dw-debug/buck-converter/docs/layout-rules-original.docx

# TL494 + PNP（TIP32A）Buck PCB 布局完整笔记

电感磁芯正下方 ❌ 地铜挖掉（keepout）

适用电路：TL494 推挽输出驱动 PNP 高边功率管（TIP32A）的 Buck 降压电路，Vin 10–40V，Vout 5V/1A。

本电路特殊结构：TL494 的 7 脚（GND）接输出负端 V-，芯片浮在 V- 上，以 V- 为参考零点。

本笔记结合电路原理深度讨论与 PCB 实操布局规则，重点厘清「高频换流环路」「7脚浮地结构」「V- 地分割」「电压环反馈」「SW 与地铜间距」「反馈电阻与采样点布局」等核心概念。

# 第 0 条：先分清两类规则（全部布局的总纲）

对象 | 物理本质 | 布局规则
电流 di/dt 大 | 寄生电感产生电压尖峰 v = L·di/dt | 走线尽量短，压缩环路面积
电压 dV/dt 大 | 对地寄生电容反复充放电 → 损耗、振铃、EMI、天线辐射 | 铜皮面积能小就不铺

注意：一个节点可能两条都占。SW 节点就是"di/dt 和 dV/dt 双高"，所以对它：短是第一位的，不铺大铜皮是第二位的。优先级：短 > 粗 > 不铺。

# 一、电路结构与高频环路识别

## 1.1 电路整体结构

- 功率管：Q1 = TIP32A（PNP），发射极接 VCC，集电极 = SW 节点
- PWM 控制器：U1 = TL494，8/9 脚并联输出，经 R3 驱动 Q1 基极
- 续流二极管：D1 = MR850（超快恢复），阴极接 SW，阳极接系统地 GND
- 输出滤波：L1(1mH) + CE1(47μF) + C2(1μF)
- 电流采样：R9/R10 并联（各 0.22Ω，总 0.11Ω），串联在 V- 与系统地 GND 之间
- 指示灯：R1(150Ω) + LED1，串联在 V+ 与 V- 之间
- ⚠️ 特殊结构：TL494 的 7 脚（GND）接 V-（输出负端），不是系统地 GND。芯片所有电压以 V- 为参考。

## 1.2 高频换流环路：C3 ↔ Q1 ↔ D1

- 必须压缩环路总面积，这是抑制尖峰、EMI 的第一要务。
- C3：输入功率电容（100μF/50V 电解）+ C1(1μF) 并联，改善高频特性。
- 本电路有 C1(1μF) 并联在电解两端，高频换流主要由 C1 承担，C3 负责低频储能。
- Q1：TIP32A PNP，发射极接 VCC（固定电位，dV/dt≈0），集电极是 SW 节点。
- D1：续流二极管（MR850，超快恢复），阳极接系统地 GND。
- SW 节点电压在 VCC ↔ GND 之间高速跳变，是板上 dV/dt 最大的点。
- C1（高频陶瓷）必须紧贴 Q1 发射极–D1 阳极，高频环路按 C1–Q1–D1 布局。

## 1.3 外部电源 vs 输入电容：电流角色不同

- 外部 VCC 电源：提供平均电流，瞬时波动很小。
- 输入电容 C3/C1：Q1 导通瞬间放电送出大瞬时电流；Q1 关断时电源再补电荷。
- 结论：C3 前面平均电流不变；C3 后面（C3 到 Q1）瞬时电流高速跳变，走线必须短。

## 1.4 输出储能回路（不属于高频换流环路）

- 路径：SW → L1 → V+ → 负载 → V- → R9/R10 → GND → D1 → SW
- 电感电流连续，di/dt 远小于 SW 换流环路，这条支路要求宽松。
- 重要区分：电感电流平均值稳定，但瞬时是带纹波的三角脉动电流，不是纯直流。

## 1.5 两个"环路"概念必须分清

概念 | 包含元件 | 电流特征 | 布局要求
高频换流环路 | C1(陶瓷)–Q1–D1 | 开关边沿瞬间阶跃跳变，di/dt 极大 | 必须压缩环路面积，走线极短
功率电流回路 | SW–L1–负载–R9/R10–GND | 三角波缓慢起伏，di/dt 小但幅值大 | 环路要求宽松，但承载主功率大电流

R9/R10 不在高频换流环路内，但主功率电流全部流过 R9/R10，存在脉动压降。

# 二、SW 节点布局（最容易踩坑）

## 2.1 走线规则

- SW 走线：Q1 集电极 → D1 阴极 → L1 左端，粗而短，总长控制在 1cm 以内。
- 首选：1~2mm 粗走线；备选：几毫米局部小铜皮。
- 禁止：整片铺铜、大面积铜皮、跨层延伸、铜皮伸到电感/反馈线/芯片下方。

## 2.2 为什么 SW 不能铺铜，而 VCC 可以？

- SW 电压在 VCC ↔ GND 高速翻转，dV/dt 极大。铺铜增大对地寄生电容，带来额外开关损耗、振铃、EMI。
- VCC 走线（C3 正极 → Q1 发射极）：电流 di/dt 同样大，但电位固定，dV/dt≈0，可以铺铜，只要求短。
- 结论：电流快 → 走线要短；电压跳变快 → 不能铺铜。

## 2.3 SW 与地铜的间距

输入电压 VCC | 推荐间距 | 说明
≤ 12V | ≥ 0.3mm（12mil） | 主要防寄生电容
12~24V | ≥ 0.4~0.5mm（16~20mil） | 常用范围
24~40V | ≥ 0.5~0.8mm（20~32mil） | 本电路最高 40V，建议取 0.5mm 以上

- 本电路 VCC 最高 40V，建议间距 ≥ 0.5mm（20mil）。
- SW 走线两侧的地铜（系统地 GND）全部遵守此间距，不要紧贴。

⚠️ 重要：SW 与地铜的间距只影响 SW 对地寄生电容，与高频换流环路面积没有直接关系。

- 高频环路面积由 Q1、D1、C1 的物理位置和走线长度决定，SW 到地铜的空隙不改变环路边长。
- 间距不需要无限大，0.3~0.8mm 后收益边际递减。

## 2.4 上层走 SW，底层能不能铺 GND？

✅ 可以铺底层 GND，但 SW 走线正下方的底层地铜必须挖空。

方案 | 做法 | 效果
✅ 推荐 | 底层铺 GND，SW 正下方挖空 | 既有完整地平面做参考，又避免 SW 寄生电容
❌ 不推荐 | 底层完整 GND，SW 直接在上面 | 寄生电容大，开关尖峰、EMI 明显变差
❌ 极端 | 底层完全不铺地 | 信号地没有参考平面，回路面积大，反而更差

- 挖空范围：以 SW 走线为中心，向两侧各扩展 0.5~1mm，底层地铜全部挖掉；挖空长度 = SW 走线全长。
- 挖空只针对 SW 垂直投影区域，其他区域保留完整地平面。
- 注意：本电路底层地是系统地 GND（不是 V-），SW 正下方挖的是 GND 铜。

# 三、7 脚浮地结构与电压反馈（核心原理）

## 3.1 7 脚接 V- 的特殊结构

本电路 TL494 的 7 脚（GND）不是接系统地 GND，而是接输出负端 V-。

- 芯片所有内部电路以 V- 为 0V 参考点（浮地结构）。
- Vref（14 脚）= 5V，是相对于 V- 的 5V。
- VCC（12 脚）供电电压 = 输入 VCC − V-，对芯片来说是正电源。
- 系统地 GND 相对于 V- 的电压 = −I_load × R_sense（负电压，因为电流从 V- 经 R9/R10 流向 GND）。

## 3.2 电压反馈环结构（已确认正确）

引脚连接：

- 1 脚 IN1+（同相）：通过 R8(5.1K) 接 V+（输出正端）。输入阻抗极高，1 脚电压 ≈ V+（相对于 V-），即 ≈ Vout。
- 2 脚 IN1-（反相）：通过 R12(5.1K) 接 Vref（5V 基准），通过 R6(1M) 接 V-（芯片地）。
- R8 和 R12 没有连在一起，分别属于 1 脚和 2 脚，不构成分压网络。

2 脚基准电压计算：

- V(2脚) = 5V × R6 / (R6 + R12) = 5V × 1M / (1M + 5.1K) ≈ 4.975V ≈ 5V
- 因为 R6(1M) >> R12(5.1K)，V- 通过 R6 对 2 脚的影响被衰减约 200 倍，2 脚近似为固定 5V 基准。

负反馈闭环推演：

- Vout ↑ → 1 脚电压 ↑ → 误差放大器输出 COMP(3脚) ↑
- TL494 内部 PWM 比较器：COMP 接同相端，锯齿波接反相端 → COMP ↑ → 锯齿波大于 COMP 的时间变短 → 输出低电平时间变短
- PNP 管 Q1：8/9 脚输出低电平 = 导通 → 低电平时间变短 = Q1 导通时间缩短
- Q1 导通时间缩短 → 向电感输送能量减少 → Vout ↓（回归稳压值）✅
- 稳压条件：1 脚 ≈ 2 脚 → Vout ≈ 5V ✅

⚠️ 关键理解：TL494 的 PWM 比较器自带一次相位反转（COMP 升高反而压缩导通脉冲），叠加 PNP 低电平导通，整体环路为负反馈。

## 3.3 电流采样环（15/16 脚）

- 15 脚 IN2-（反相）：R7(5.1K) 接 Vref，R11(5.1K) 接 V-（芯片地）→ 15 脚 = 2.5V 基准（相对于 V-）。
- 16 脚 IN2+（同相）：接电流采样点。
- R9/R10 并联 = 0.11Ω，串联在 V- 与系统地 GND 之间。
- V- 相对于 GND = I_load × 0.11Ω（正电压）；GND 相对于 V- = −I_load × 0.11Ω（负电压）。

⚠️ 电流环接法注意事项：

- 如果 16 脚接系统地 GND：GND 相对于芯片地（V-）是负电压，TL494 输入引脚不能正常处理负电压，电流环可能无法工作。
- 如果 16 脚接 V-：16 脚 = 0V，15 脚 = 2.5V，IN2+ < IN2-，永远不触发保护。
- 建议：确认 16 脚实际连接。若要正常实现过流保护，需将采样电阻移到 V+ 高边，或使用差分电平转换。

## 3.4 过流保护阈值（当前参数）

- 若电流环按 15 脚=2.5V 基准、采样电阻 0.11Ω 计算：
- 保护电流 = 2.5V / 0.11Ω ≈ 22.7A
- 对 5V/1A 电路来说阈值过高，输出短路时保护可能来不及动作。
- 建议优化：将 R7 改为 47K（R11 保持 5.1K），15 脚基准降至 ≈0.48V，保护电流 ≈4.4A。

# 四、地分割：V- 分割（核心布局规则）

## 4.1 为什么分割 V-，不分割 GND？

分割地的根本原则：芯片的参考零点（7 脚接的那个网络），不能让功率大电流流过，否则地弹污染基准。

网络 | 芯片是否参考 | 流过电流 | 是否需要分割
V-（输出负端） | ✅ 是，7脚=V-，芯片参考零点 | 全部负载电流（经 R9/R10 流向 GND） | ✅ 必须分割
GND（系统地） | ❌ 没有芯片引脚接 GND | D1续流电流、C3脉冲电流、R9/R10电流 | ❌ 不需要，全是功率地

- 普通 Buck：7 脚接 GND → 分割 GND。
- 本电路：7 脚接 V- → 分割 V-。GND 全是功率元件，整片铺铜不用分。

## 4.2 V- 具体分割方式

V- 物理上分成两块铜：

功率 V- 铜（承载大电流）：

- 包含：输出 V- 端子、CE1/C2 负极、LED 负极、R9/R10 上端（V- 侧）
- 承载全部负载电流，大面积铺铜
- 止步于 R9/R10 上端，不延伸到 TL494 芯片区域

信号 V- 铜（芯片参考地）：

- 包含：TL494 的 7 脚、R6 下端、R11 下端、补偿网络地、其他以 V- 为参考的小信号元件
- 只有 μA 级小信号电流，电位稳定，给芯片提供干净的 0V 参考

单点连接：

- 功率 V- 和信号 V- 只在一处相连，连接点选在 **R9/R10 上端（V- 侧）**
- 这里是功率 V- 的终点，功率电流全部流入 R9/R10，不再往前流，电位最平稳
- 用一根短线或 0Ω 电阻连接
- ❌ 禁止在输出电容负极或负载端子处连接（那里功率电流大、地弹大）
- ❌ 禁止多点连接（形成地环路）

## 4.3 GND（系统地）处理

- 不需要分割，整片铺功率铜。
- 包含：D1 阳极、C3 负极、C1 负极、R9/R10 下端、输入电源负极。
- 大面积铺铜，降低阻抗，承载功率大电流。
- 因为没有芯片小信号参考 GND，不用担心地弹污染基准。

## 4.4 分割结构示意

输出 V- 端子 ──[功率 V- 铜，大电流]──┬── CE1/C2 负极

├── LED 负极

└── R9/R10 上端（V- 侧）

│

[单点连接] ← 唯一连接处

│

┌── 7 脚（TL494 地）

├── R6 下端、R11 下端

└── 其他小信号元件地

[信号 V- 铜，μA级小电流]

# 五、反馈电阻与采样点布局

## 5.1 反馈电阻必须靠近 TL494 芯片

- R8、R12、R6、R4、C4、R7、R11 全部连接 TL494 高阻抗引脚（1/2/3/14/15 脚），输入阻抗 MΩ 级，极易耦合噪声。

走线类型 | 电流大小 | 是否可以长 | 布局要求
采样线（V+/V- → 反馈电阻） | nA~μA级 | ✅ 可以长 | 0.2~0.3mm 细线，从输出端子引出
反馈电阻 → 芯片引脚 | 高阻抗节点 | ❌ 必须短 | 电阻紧贴芯片，引脚走线尽量短
功率走线（L1→C4→V+端子） | A级大电流 | 尽量短粗 | 宽铜皮，承载大电流

核心原则：采样点靠近输出端子，反馈电阻靠近芯片，中间用细采样线连接。

## 5.2 反馈采样点位置

- V+ 采样：从输出 V+ 端子（或 CE1 正极）引出细采样线 → R8 → 1 脚。
- V- 参考：2 脚通过 R6 接信号 V-（芯片地），不需要额外从功率 V- 引线。
- ❌ 不要从 L1→C4 之间的功率走线取 V+ 采样，那段走线上流过全部电感电流，有 IR 压降和 L·di/dt 尖峰，且靠近 SW/电感，磁场干扰强。
- L1 和 CE1 尽量靠近，缩短 L1→CE1 功率走线，减小 IR 压降和寄生电感。

## 5.3 反馈走线注意事项

- 反馈采样线用 0.2~0.3mm 细线，远离 SW 走线和 L1 电感，不要平行走。
- 反馈线不要从高频换流环路（C1-Q1-D1）上方或下方穿过。
- R8、R12、R6 等反馈电阻放在 TL494 周边的小信号区，不放功率区。
- 补偿电容 C4(104) 紧贴 2 脚、3 脚，引线尽量短。

# 六、分区布局：功率区 / 小信号控制区

## 6.1 功率区

- 包含：C3、C1、Q1、D1、L1、CE1、C2、R9/R10、R1/LED1
- C1（高频陶瓷）、C3、Q1、D1 四者紧靠，构成紧凑的换流三角。
- 系统地 GND 大面积铺铜（纯功率地，不分割）。
- 功率 V- 铜承载负载大电流，止步于 R9/R10 上端。
- L1、CE1/C2 属低频回路，V+ 可铺铜。
- L1 和 CE1 尽量靠近。

## 6.2 小信号区

- 包含：TL494 及反馈电阻（R8、R12、R6、R4、R7、R11）、补偿电容（C4）、定时元件（R5、C5）。
- TL494 不得放在高频环路包围/投影范围内，远离电感磁场。
- TL494 12 脚 VCC 紧贴引脚加 0.1μF 去耦电容（原理图无，PCB 必须补），去耦电容另一端接信号 V-（7脚）。
- 14 脚 Vref 旁同样建议加 0.1μF 去耦（到信号 V-）。
- 定时元件 R5(47K)、C5(102) 紧贴 5、6 脚。
- 反馈电阻紧贴 TL494 的 1/2/3 脚，高阻抗节点走线尽量短。
- 信号 V- 铜只覆盖小信号区，通过单点连到功率 V-（R9/R10 上端）。

# 七、基极驱动走线：TL494（8/9 脚）→ R2/R3 → Q1 基极

- 走线尽量短，0.2~0.3mm 细线即可，不用加宽。
- R2(47Ω)：Q1 基极到发射极（VCC）的关断泄放电阻，帮助 Q1 快速关断。
- R3(150Ω)：8/9 脚到 Q1 基极的驱动限流电阻。
- R2、R3 紧贴 Q1 基极，让 R2/R3/Q1 基极构成紧凑的小驱动环路。
- 长线寄生电感 → 开关瞬间振铃电压尖峰；长线像天线 → 拾取噪声误触发；长线电阻 → 驱动不足发热。

# 八、走线宽度规范（1oz 外层铜）

网络 | 处理方式
VCC（C3 正极 → Q1 发射极） | 可铺铜 / 1.5~2mm
SW 节点 | 1~2mm 粗短线，禁止大面积铺铜
SW 与 GND 间距 | ≥ 0.5mm，底层 SW 正下方挖空
L1 → CE1 → V+ 功率走线 | 宽铜皮 / 1.5~2mm，尽量短
V+ 输出 | 允许大面积铺铜
功率 V- 铜 | 功率区大面积铺铜，止步于 R9/R10 上端
信号 V- 铜 | 小信号区铺铜，仅 μA 级电流
GND（系统地） | 整片铺功率铜，不分割
V+ 采样线 | 0.2~0.3mm 细线，从输出端子引出
基极驱动、反馈电阻、补偿、定时 | 0.2~0.3mm 细线，电阻紧贴芯片

# 九、避坑清单

- ❌ SW 走线大面积铺铜 / 铺成天线
- ❌ SW 与 GND 间距过小（< 0.3mm），寄生电容大
- ❌ 上层走 SW，底层 GND 不挖空，SW 正下方寄生电容大
- ❌ 误以为 SW 与地铜间距变大会增大高频环路面积（二者无直接关系）
- ❌ C1（高频陶瓷）放远，高频环路面积大
- ❌ C3/C1 放到 TL494 旁边
- ❌ TL494 放在高频环路包围区域内
- ❌ 分割 GND 而不分割 V-（本电路 7 脚=V-，应该分割 V-，GND 是纯功率地不用分）
- ❌ 功率 V- 铜延伸到 TL494 小信号区域
- ❌ 功率 V- 和信号 V- 多点连接，或在输出电容负极处连接（应在 R9/R10 上端单点连接）
- ❌ 功率大电流流过信号 V- 铜（TL494 下方）
- ❌ 反馈电阻（R8/R12/R6）放在功率区，远离 TL494，高阻抗节点走线长
- ❌ V+ 采样点取在 L1→CE1 之间的功率走线上（应取输出端子或 CE1 正极）
- ❌ 反馈采样线靠近 SW 走线、电感，或从高频环路上方穿过
- ❌ L1 和 CE1 距离过远，L1→CE1 走线过长
- ❌ 拉长基极驱动走线，或 R2/R3 远离 Q1 基极
- ❌ 省略 TL494 12 脚 VCC 去耦电容（去耦到信号 V-，不是 GND）
- ❌ 续流二极管 D1 用普通慢管或放远，环路面积变大
- ❌ 16 脚接系统地 GND（相对于 V- 是负电压，TL494 无法处理，需确认接法）
- ❌ 过流保护阈值过高（当前约 22.7A，建议降低基准到 0.5V 左右）
- ❌ LED 限流电阻 150Ω 偏小（电流约 20mA，建议 330~470Ω）

# 十、核心口诀

电流突变，走线缩短；电压猛跳，少铺大铜；
先缩环路，再谈铺铜；高频小容，贴紧功率；
七脚接V负，芯片浮在地；
分地看七脚，接谁就分谁；
V负分两块，单点在采样；
GND全功率，整片铺铜皮；
电阻靠近芯片，采样靠近端子；
SW离地半毫米，底层正下要挖空。

一句话记忆：7 脚接谁，谁就是芯片参考地，谁就需要分割功率/信号。本电路 7 脚接 V-，所以分割 V-，GND 不用分。

一句话记忆：SW 与地铜间距只影响寄生电容，不直接影响高频环路面积；上层走 SW，底层铺地但正下方挖空。

一句话记忆：反馈电阻靠近芯片，采样点靠近输出端子，中间细采样线连接。

一句话记忆：TL494 的 PWM 比较器自带相位反转，COMP 升高反而压缩导通脉冲，叠加 PNP 低电平导通形成负反馈。
