dw-debug/buck-converter/docs/BOM.csv

Name | Description | Designator | Footprint | LibRef | Quantity | 参数 | BOM名称
1uF | 贴片电容/MLCC电容 | C1, C2, C3, C6 | C0805_L | C | 4 |  | 无极性贴片电容
104 | 瓷片电容 | C4 | CC 2.2*5 | CC | 1 |  | 直插瓷片电容
102 | 瓷片电容 | C5 | CC 2.2*5 | CC | 1 |  | 直插瓷片电容
47uF/25V | 直插电解电容 | CE1 | CE-2.0*5*11 | CE | 1 |  | 直插电解电容
100uF/50V | 直插电解电容 | CE2 | CE-3.5*8*11.5 | CE | 1 |  | 直插电解电容
MR850 | 恢复二极管整流器 | D1 | DO-201AD | FR307 | 1 |  | 恢复二极管整流器
TL494 | 电源管理IC | i1 | DIP16-300 | TL494 | 1 |  | 电源管理IC
HDR-1X2 | 2P接插件 | JP1, JP2, JP3, JP4 | KF2EDGK5.08-LI-2P | Header 2 | 4 |  | 2P接插件 | 是U型针
1mH | 功率磁环电感 | L1 | LMR135 | L-MR | 1 |  | 功率磁环电感
红色 | 贴片LED | LED1 | LED0603_R | LED | 1 |  | 贴片LED
TIP32A | PNP型中功率三极管 | Q1 | TO220A | TIP42C | 1 | 100V 6A 65W | 互补功率-PNP型
150 | 直插色环电阻 | R1 | RS 1/2W | R-DIP | 1 |  | 色环电阻
47 | 直插色环电阻 | R2 | RS 1/4W | R-DIP | 1 |  | 色环电阻
150 | 直插色环电阻 | R3, R11 | RS 1/4W | R-DIP | 2 |  | 色环电阻 | R3可以大一点限流
47K | 直插色环电阻 | R4, R5 | RS 1/4W | R-DIP | 2 |  | 色环电阻
1M | 直插色环电阻 | R6 | RS 1/4W | R-DIP | 1 |  | 色环电阻
5.1K | 直插色环电阻 | R7, R8, R12 | RS 1/4W | R-DIP | 3 |  | 色环电阻
0.22 | 直插色环电阻 | R9, R10 | RS 1/4W | R-DIP | 2 |  | 色环电阻
15.5*10.5*21 | 产品尺寸:15.5*10.5*21MM;材 质:6063-T5; | U1 | PCBComponent_1 | 15.5*10.5*21 | 1 |  |  | 别忘记了，买云母绝缘片
