dw-debug/buck-converter/(list of files, cad)

Other CAD files:
hardware/PCB1.DWG
Sheet1.dwg
hardware/Sheet1.dwg
