dw-debug/buck-converter/docs/layout-guidelines.md

# TL494 + PNP Buck PCB 布局规则

> 适用对象：TL494 推挽输出直接驱动 PNP 高边管（TIP32A）的 Buck 降压电路，V<sub>in</sub> 10–40 V，V<sub>out</sub> 5 V / 1 A。
> 本文由布局笔记整理（原稿见 [layout-rules-original.docx](layout-rules-original.docx)），可直接当作改板 checklist 使用。
> 本电路的关键特殊结构：**TL494 的 7 脚（GND）接输出负端 V-**，芯片以 V- 为 0 V 参考，即"浮地"结构——后面所有地分割规则都由这一条推出。

---

## 0. 总纲：先分清两类规则

| 物理本质 | 后果 | 布局规则 |
| --- | --- | --- |
| 电流 di/dt 大 | 寄生电感产生电压尖峰 v = L·di/dt | 走线尽量短，压缩环路面积 |
| 电压 dV/dt 大 | 对地寄生电容反复充放电 → 损耗、振铃、EMI、天线辐射 | 铜皮面积能小就小 |

一个节点可能两条都占（SW 节点就是 di/dt 与 dV/dt 双高）。**优先级：短 > 粗 > 不铺。**

## 1. 电路结构与两个"环路"

| 概念 | 包含元件 | 电流特征 | 布局要求 |
| --- | --- | --- | --- |
| **高频换流环路** | 输入高频电容（C1 1 µF）– Q1 – D1 | 开关边沿瞬间阶跃，di/dt 极大 | 必须压缩环路面积，走线极短 |
| **功率回路** | SW–L1–负载–R9/R10–GND | 三角波缓慢起伏，di/dt 小但幅值大 | 要求宽松，但要走足够宽 |

- 输入侧：电解 CE2（100 µF/50 V，笔记原文记作 C3）+ C1（1 µF）并联。**高频换流由 C1 承担，CE2 只负责低频储能**，所以 C1 必须紧贴 Q1 发射极–D1 阳极。
- 输入电解之前的平均电流不变；**CE2 到 Q1 之间瞬时电流高速跳变**，该段走线才要短。
- R9/R10 不在高频换流环路内，但主功率电流全部流过它（存在脉动压降），故功率回路与换流环路要分开考虑。

## 2. SW 节点（最容易踩坑）

- 走线：Q1 集电极 → D1 阴极 → L1 左端，**粗而短，全长 ≤ 1 cm**；首选 1–2 mm 粗线，备选几毫米局部小铜皮。
- **禁止**：整片铺铜、大面积铜皮、跨层延伸、铜皮伸到电感 / 反馈线 / 芯片下方。
- 为什么 SW 不能铺铜而 VCC 可以：SW 电位在 VCC ↔ GND 之间高速翻转（dV/dt 极大），铺铜等于加大对地寄生电容 → 开关损耗、振铃、EMI；VCC 走线 di/dt 同样大但**电位固定、dV/dt≈0**，所以可以铺铜，只要求短。
- SW 与地铜间距（本电路最高 40 V）：

  | VCC | 推荐间距 |
  | --- | --- |
  | ≤ 12 V | ≥ 0.3 mm (12 mil) |
  | 12–24 V | ≥ 0.4–0.5 mm (16–20 mil) |
  | 24–40 V | ≥ 0.5–0.8 mm (20–32 mil) |

  0.3–0.8 mm 之后收益边际递减，不必无限加大。
- ⚠️ SW 与地铜的间距**只影响 SW 对地寄生电容，与高频换流环路面积没有直接关系**；环路面积由 Q1、D1、C1 的物理位置和走线长度决定。
- 底层可以铺 GND，但 **SW 走线正下方的底层地铜必须挖空**：以 SW 走线为中心向两侧各扩 0.5–1 mm，挖空长度 = SW 走线全长；其他区域保留完整地平面。挖的是**系统地 GND 铜**（不是 V-）。

## 3. 地分割：分割 V-，不分割 GND

分割地的根本原则：**芯片的参考零点（7 脚所在的网络）不能让功率大电流流过**，否则地弹污染基准。本电路 7 脚接 V-，所以分割的是 V-。

| 网络 | 芯片是否参考 | 流过电流 | 是否分割 |
| --- | --- | --- | --- |
| V-（输出负端） | ✅ 7 脚 = V-，芯片参考零点 | 全部负载电流（经 R9/R10 流向 GND） | ✅ 必须分割 |
| GND（系统地） | ❌ 无芯片引脚接 GND | 续流电流、输入脉冲电流、R9/R10 电流 | ❌ 不需要，整片功率铜 |

**功率 V- 铜**（大电流）：输出 V- 端子、CE1/C2 负极、LED 负极、R9/R10 上端（V- 侧）。大面积铺铜，**止步于 R9/R10 上端**，不延伸到 TL494 区域。

**信号 V- 铜**（芯片参考地，仅 µA 级）：TL494 的 7 脚、R6/R11 下端、补偿网络地、其他以 V- 为参考的小信号元件。只覆盖小信号区，电位稳定。

**单点连接**：两块 V- 只在一处相连，连接点选在 **R9/R10 上端（V- 侧）**——这里是功率 V- 的终点，功率电流全部流入采样电阻、不再前流，电位最平稳；用一段短线或 0 Ω 电阻连接。

```
输出 V- 端子 ──[功率 V- 铜，大电流]──┬── CE1/C2 负极
                                     ├── LED 负极
                                     └── R9/R10 上端 (V- 侧)
                                            │
                                      [单点连接]  ← 唯一连接处
                                            │
                                     ┌── 7 脚 (TL494 地)
                                     ├── R6 / R11 下端
                                     └── 其他小信号元件地
                                     [信号 V- 铜，µA 级]
```

❌ 禁止在输出电容负极或负载端子处单点连接（那里功率电流大、地弹大）；❌ 禁止多点连接（形成地环路）。

## 4. 电压反馈与采样

- **IN1+（1 脚）**经 R8（5.1 K）接 V+，输入阻抗 MΩ 级，1 脚电压 ≈ V<sub>out</sub>。
- **IN1-（2 脚）**与 R12（5.1 K）、R6（1 M）构成基准：R6 ≫ R12，使 V- 对 2 脚的影响被衰减约 200 倍，2 脚 ≈ 4.975 V ≈ 固定 5 V 基准。
- **COMP（3 脚）**与 IN1- 之间接 R4（47 K）∥ C4（100 nF）作补偿。
- 负反馈推演：V<sub>out</sub>↑ → 1 脚↑ → COMP↑ → TL494 内部 PWM 比较器（COMP 接同相端、锯齿波接反相端）输出高电平时间变长 → 8/9 脚高电平变长 → PNP 低电平导通，**导通时间变短** → 送进电感的能量减少 → V<sub>out</sub>↓ ✅
  ⚠️ 关键理解：TL494 的 PWM 比较器自带一次相位反转，再叠加 PNP 的低电平导通，整体仍是负反馈。
- **布局三条**：采样点靠近输出端子、反馈电阻靠近芯片、中间用 0.2–0.3 mm 细采样线连接。
  - V+ 采样从输出 V+ 端子（或 CE1 正极）引出 → R8 → 1 脚。
  - ❌ 不要从 L1→CE1 之间的功率走线取 V+ 采样（流过全部电感电流，有 IR 压降与 L·di/dt 尖峰，且靠近 SW/电感）。
  - 反馈线远离 SW 走线与 L1，不平行走，不从高频环路上/下方穿过；C4 紧贴 2/3 脚。

## 5. 电流采样环（15/16 脚）

- 采样电阻 R9 ∥ R10 = **0.11 Ω**，串在 V- 与系统地 GND 之间。
- V- 相对 GND = +I<sub>load</sub> × 0.11 Ω；GND 相对 V- = −I<sub>load</sub> × 0.11 Ω（负压）。
- 15 脚（IN2-）由 R7/R11 分压建立基准，16 脚（IN2+）接采样点。
- ⚠️ **待核实**：原笔记按 R11 = 5.1 K 推算 15 脚 = 2.5 V、保护阈值 ≈ 22.7 A（对 1 A 电路明显过高）。但 BOM 中 **R11 = 150 Ω（与 R3 同值）**，R7 = 5.1 K，分压比 1:34 → 15 脚 ≈ 0.143 V、阈值 ≈ 1.3 A，与 1 A 满载 + 实测限流行为吻合。两种推算只差一个 R11 取值，**以 `hardware/PCB1.PcbDoc` 网络表为准**。
- 若确实需要降阈值：R7 改 47 K（R11 保持 5.1 K）可把基准压到 ≈0.48 V。更彻底的做法是把采样电阻移到 V+ 高边，或加差分电平转换——因为 16 脚若接系统地，相对芯片地是负压，TL494 输入无法正常处理。

## 6. 分区：功率区 / 小信号控制区

**功率区**：CE2、C1、Q1、D1、L1、CE1、C2、R9/R10、R1/LED1。四个换流元件（C1、CE2、Q1、D1）紧靠成紧凑三角；GND 整片铺铜不分割；L1 与 CE1 尽量靠近（缩短 IR 压降与寄生电感）；V+ 允许大面积铺铜。

**小信号区**：TL494 + R8/R12/R6/R4/R7/R11 + C4 + 定时元件 R5/C5。
- TL494 不得落进高频环路的包围/投影范围，远离电感磁场。
- **12 脚 VCC 紧贴引脚加 0.1 µF 去耦电容（原理图没有，PCB 必须补），另一端接信号 V-（7 脚），不是 GND**；14 脚 Vref 同样建议 0.1 µF 到信号 V-。
- R5（47 K）、C5（1 nF）紧贴 5/6 脚；反馈电阻紧贴 1/2/3 脚。

## 7. 基极驱动走线（8/9 脚 → R2/R3 → Q1 基极）

- 0.2–0.3 mm 细线即可，不必加宽，但**必须短**。
- R2（47 Ω）：Q1 基极–发射极之间的关断泄放电阻；R3（150 Ω）：驱动限流电阻。**R2/R3 紧贴 Q1 基极**，与基极构成紧凑的小驱动环路。
- 长线后果：寄生电感 → 开关振铃尖峰；像天线 → 拾取噪声误触发；走线电阻 → 驱动不足、发热。

## 8. 走线宽度与处理（1 oz 外层铜）

| 网络 | 处理方式 |
| --- | --- |
| VCC（CE2 正极 → Q1 发射极） | 可铺铜 / 1.5–2 mm |
| SW 节点 | 1–2 mm 粗短线，禁止大面积铺铜，全长 ≤ 1 cm |
| SW 与 GND 间距 | ≥ 0.5 mm，底层 SW 正下方挖空 |
| L1 → CE1 → V+ 功率走线 | 宽铜皮 1.5–2 mm，尽量短 |
| V+ 输出 | 允许大面积铺铜 |
| 功率 V- 铜 | 功率区大面积铺铜，止步于 R9/R10 上端 |
| 信号 V- 铜 | 小信号区铺铜，仅 µA 级电流 |
| GND（系统地） | 整片功率铜，不分割 |
| V+ 采样线 | 0.2–0.3 mm 细线，从输出端子引出 |
| 基极驱动 / 反馈电阻 / 补偿 / 定时 | 0.2–0.3 mm 细线，电阻紧贴芯片 |

## 9. 避坑清单

- ❌ SW 大面积铺铜 / 铺成天线；SW 与 GND 间距 < 0.3 mm；底层 GND 在 SW 正下方不挖空。
- ❌ 误以为"SW 与地铜间距变大 = 环路面积变大"（二者无直接关系）。
- ❌ C1（高频陶瓷）放远、CE2/C1 放到 TL494 旁边、TL494 落进高频环路内。
- ❌ 分割 GND 而不分割 V-；功率 V- 铜延伸到 TL494 区域；V- 多点连接或在输出电容负极处单点连接。
- ❌ 反馈电阻放功率区、远离 TL494；V+ 采样取在 L1→CE1 功率走线上；采样线靠近 SW/电感或跨过环路。
- ❌ L1 与 CE1 距离过远；基极驱动走线拉长、R2/R3 远离 Q1 基极。
- ❌ 省略 TL494 12 脚 0.1 µF 去耦（且要接到信号 V-）。
- ❌ D1 用普通慢管或放远，环路面积变大。
- ❌ LED 限流电阻 150 Ω 偏小（约 20 mA），建议 330–470 Ω。

## 10. 口诀

> 电流突变，走线缩短；电压猛跳，少铺大铜；
> 先缩环路，再谈铺铜；高频小容，贴紧功率；
> 七脚接 V 负，芯片浮在地；
> 分地看七脚，接谁就分谁；
> V 负分两块，单点在采样；
> GND 全功率，整片铺铜皮；
> 电阻靠近芯片，采样靠近端子；
> SW 离地半毫米，底层正下要挖空。

一句话记忆：

1. **7 脚接谁，谁就是芯片参考地，谁就需要分割功率/信号**——本电路 7 脚接 V-，所以分割 V-，GND 不用分。
2. SW 与地铜间距只影响寄生电容，不直接影响高频环路面积；上层走 SW，底层铺地但正下方挖空。
3. 反馈电阻靠近芯片，采样点靠近输出端子，中间细采样线连接。
4. TL494 的 PWM 比较器自带相位反转，COMP 升高反而压缩导通脉冲，叠加 PNP 低电平导通形成负反馈。

## 11. 改板自查清单

- [ ] 换流三角：C1、Q1、D1 是否紧凑，C1 是否紧贴 Q1 发射极 / D1 阳极
- [ ] SW 走线是否 ≤ 1 cm 且未铺铜；与地铜是否 ≥ 0.5 mm；底层正下方是否挖空
- [ ] V- 是否分成功率/信号两块，单点是否落在 R9/R10 上端
- [ ] 是否误分割了 GND
- [ ] TL494 是否避开电感与高频环路
- [ ] 12/14 脚 0.1 µF 去耦是否到位（接信号 V-）
- [ ] 反馈电阻是否贴芯片、采样线是否从输出端子引出并远离 SW/电感
- [ ] R7/R11 分压比与目标限流是否一致；15/16 脚接法是否经过网络表确认
- [ ] R2/R3 是否贴 Q1 基极；D1 是否为快恢复/肖特基
- [ ] LED 限流电阻是否改为 330–470 Ω
