dw-debug/buck-converter/hardware/Composite Drawing.pdf

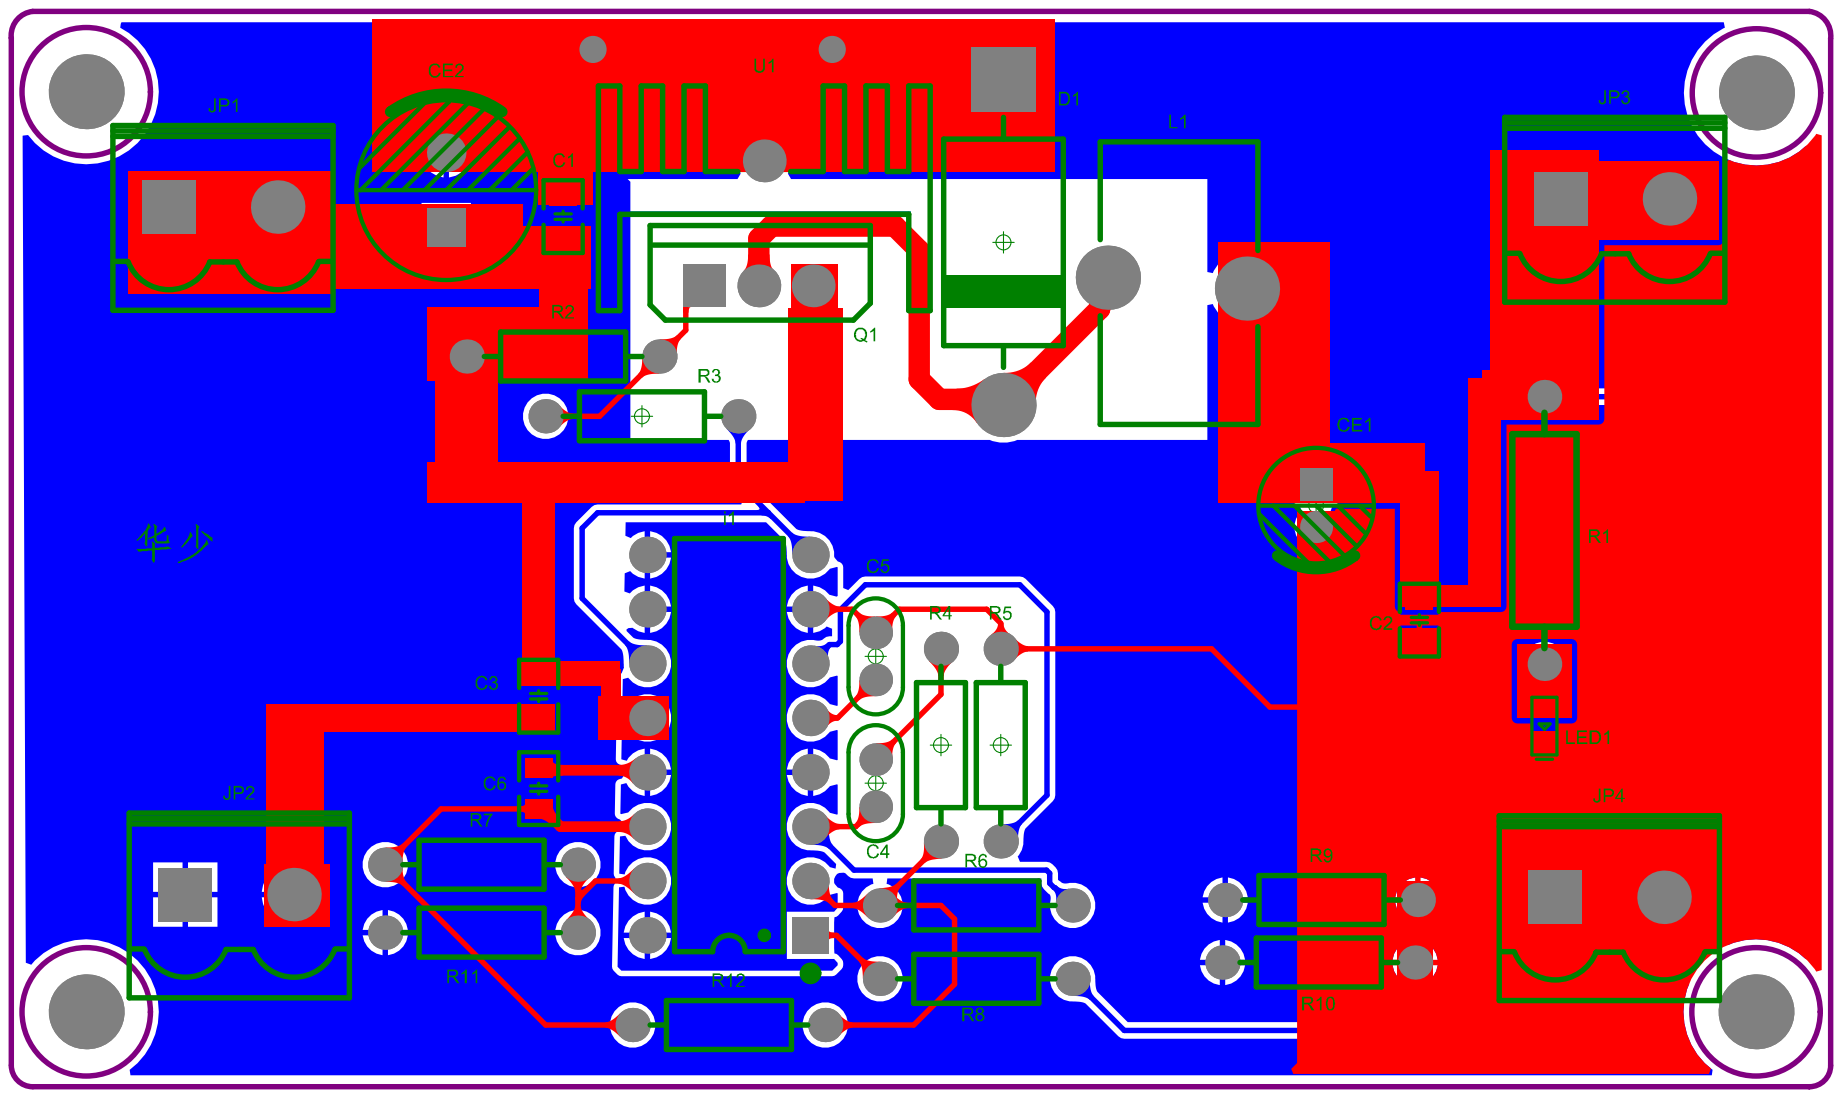
[picture p5: page 1]
