dw-debug/buck-converter/hardware/Sheet1.pdf

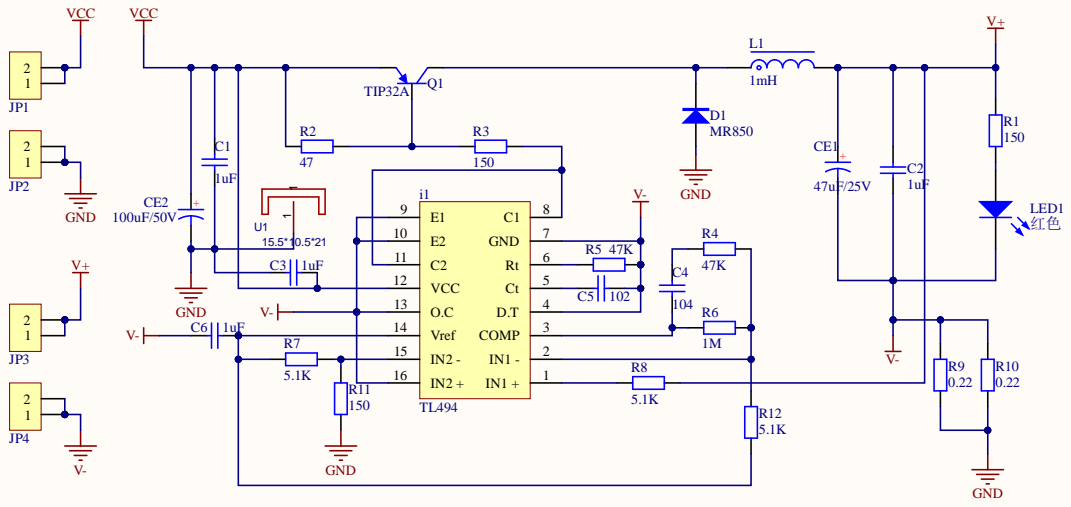
[picture p6: page 1]

1 2 | 1TL C2 Rt VCC Ct O . C D . T Vref COMP IN 2 -IN 1 -IN 2 + IN 1 +

1 0 | | 7
1 1 | | 6 | R5 4 7 K

1 3 | | 4
1 4 | | 3
1 5 | | 2
1 6

项目名 称 | b uck.Prj P cb

原理名 称 | Sheet 1.Sch D o c
项目时 间 | 2 0 2 6 / 1 0/ 1 8 1 7 : 5 3 : 1 0

设计者 | 华少
