dw-debug/buck-converter/fabrication/assembly/PCB1.pdf

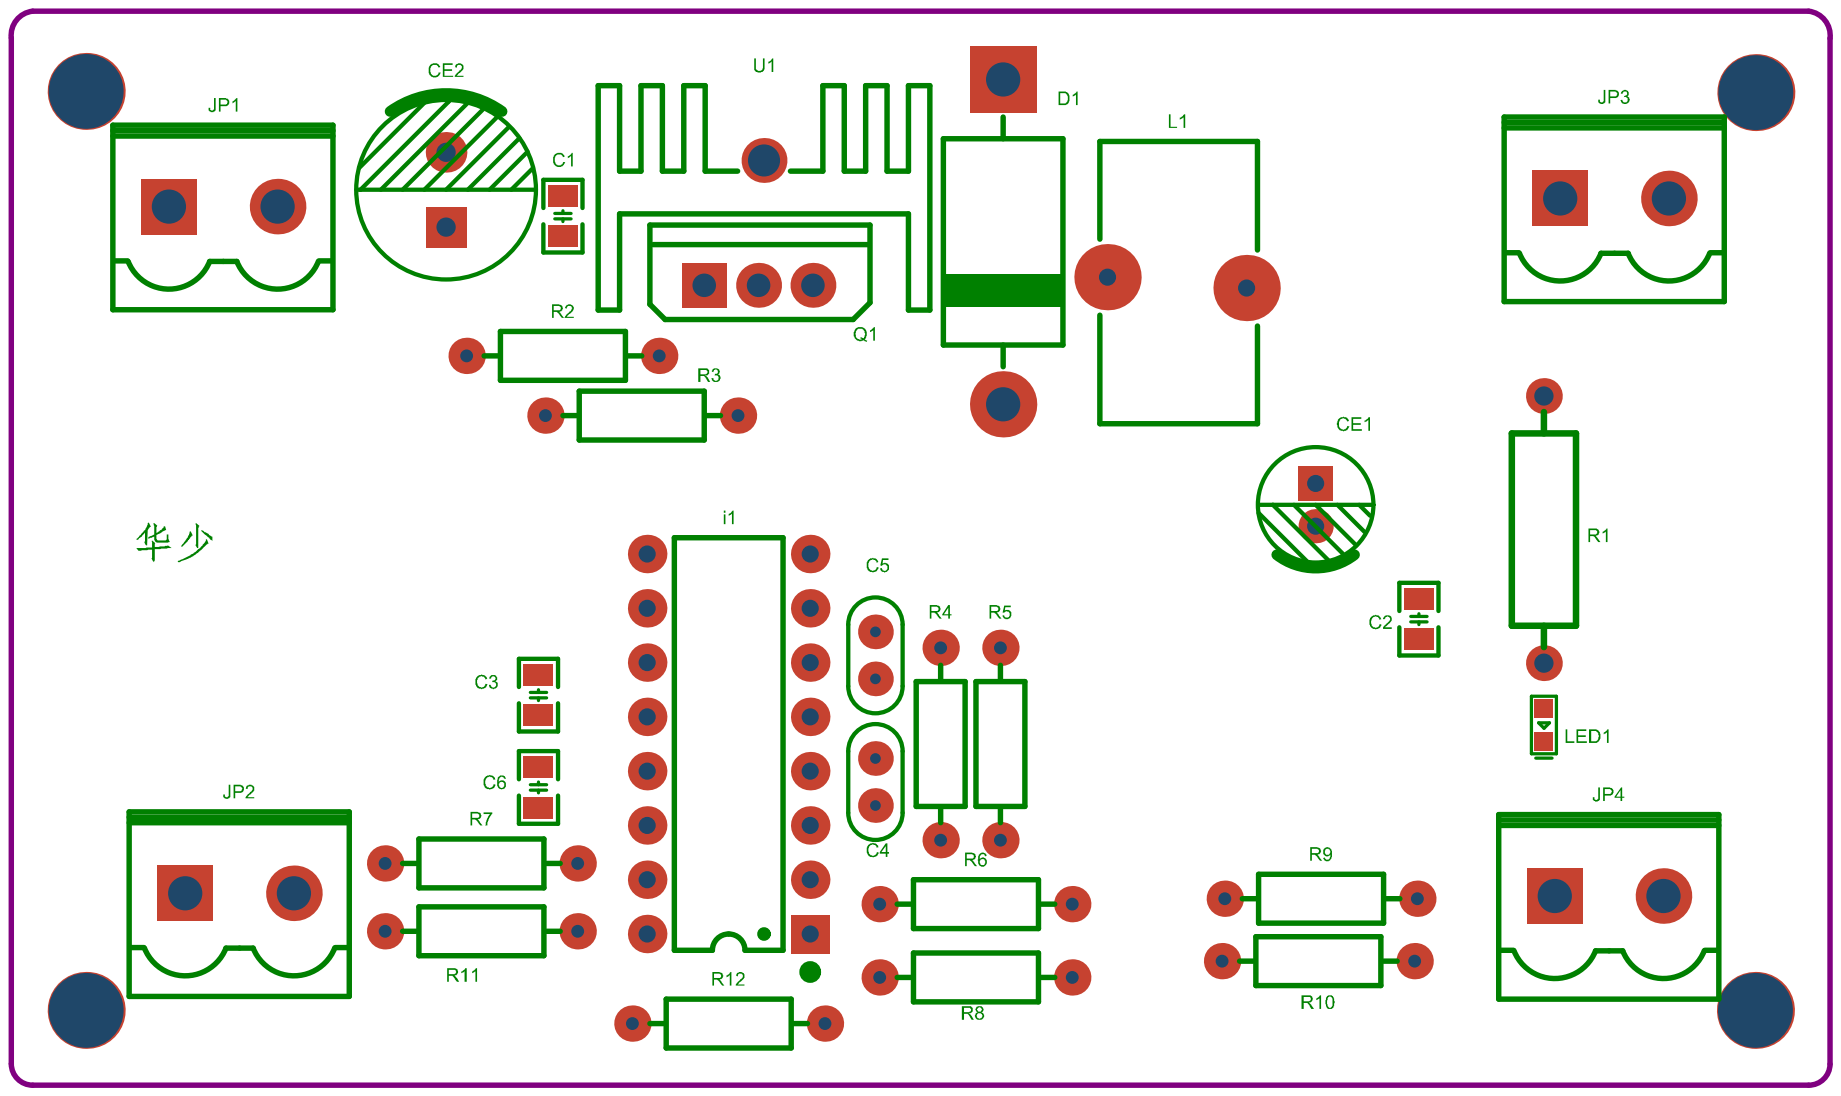
[picture p7: page 1]

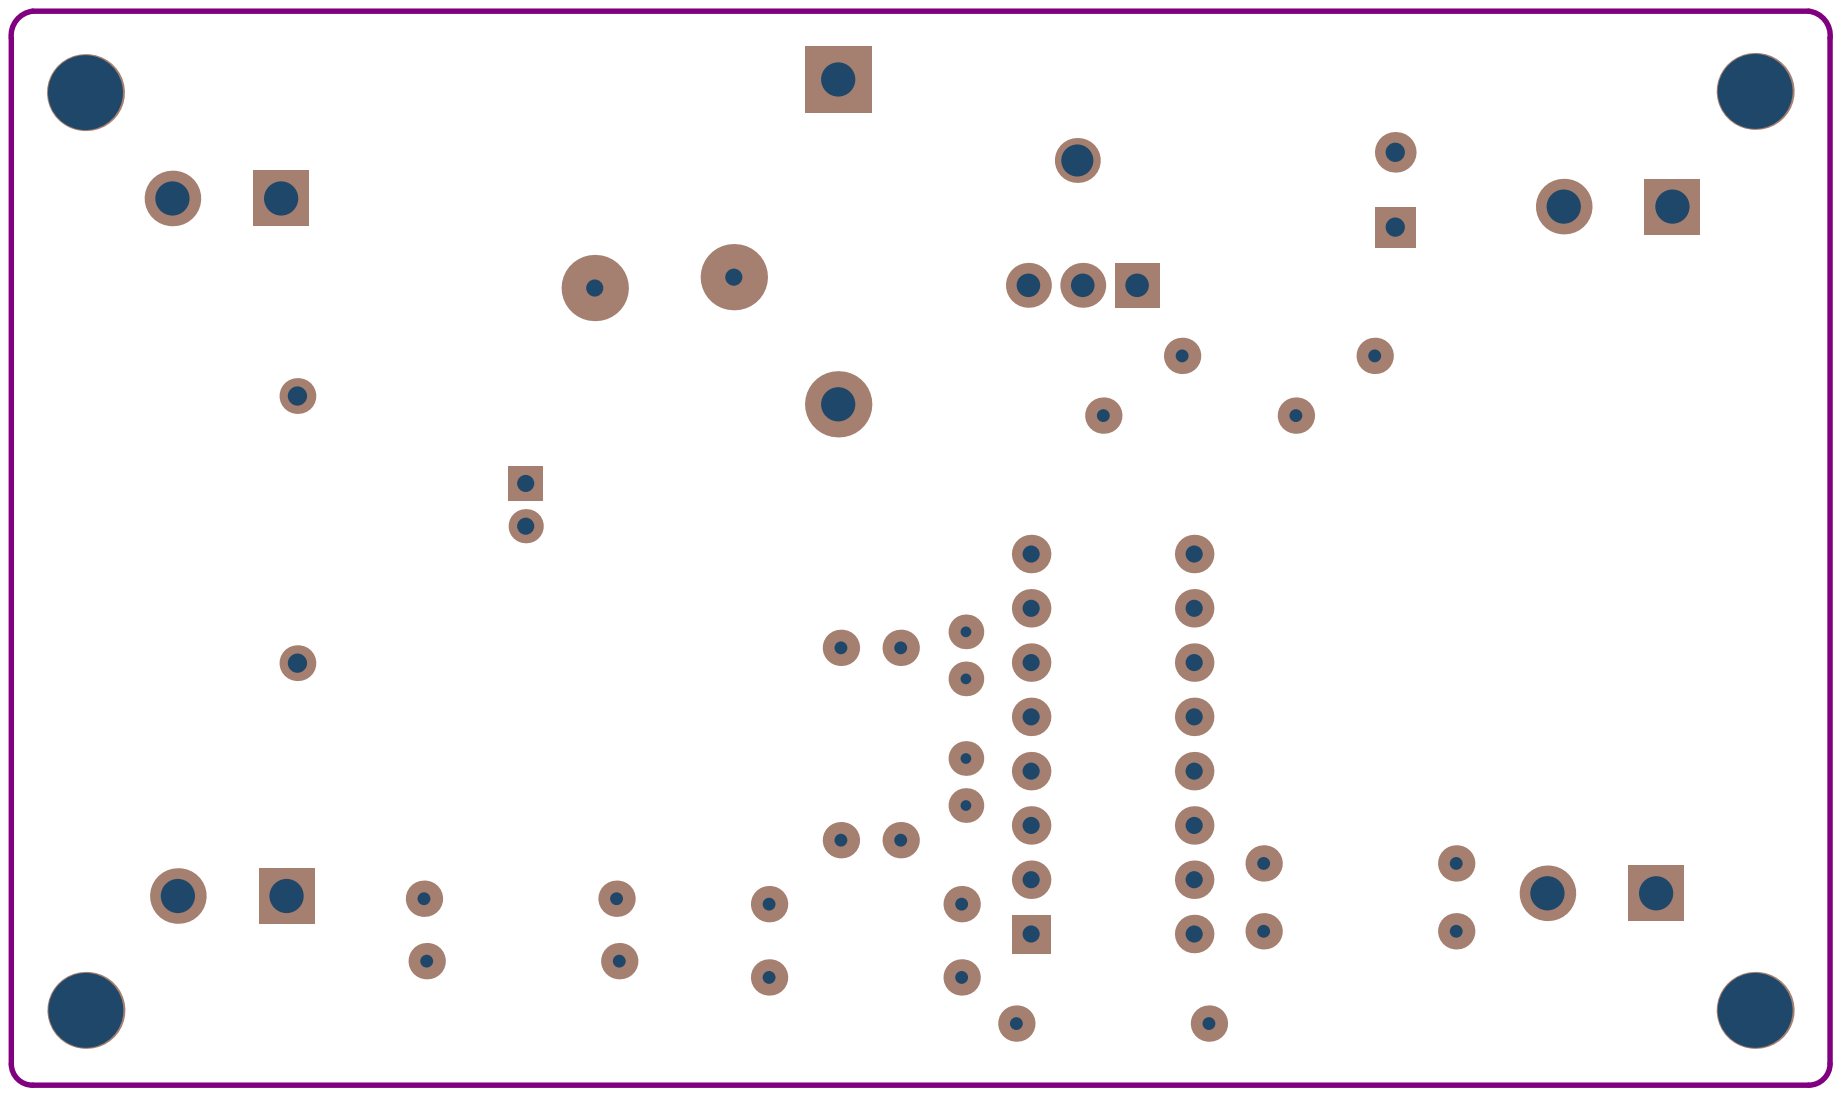
[picture p8: page 2]
