dw-debug/buck-converter/fabrication/stencil/PCB1.pdf

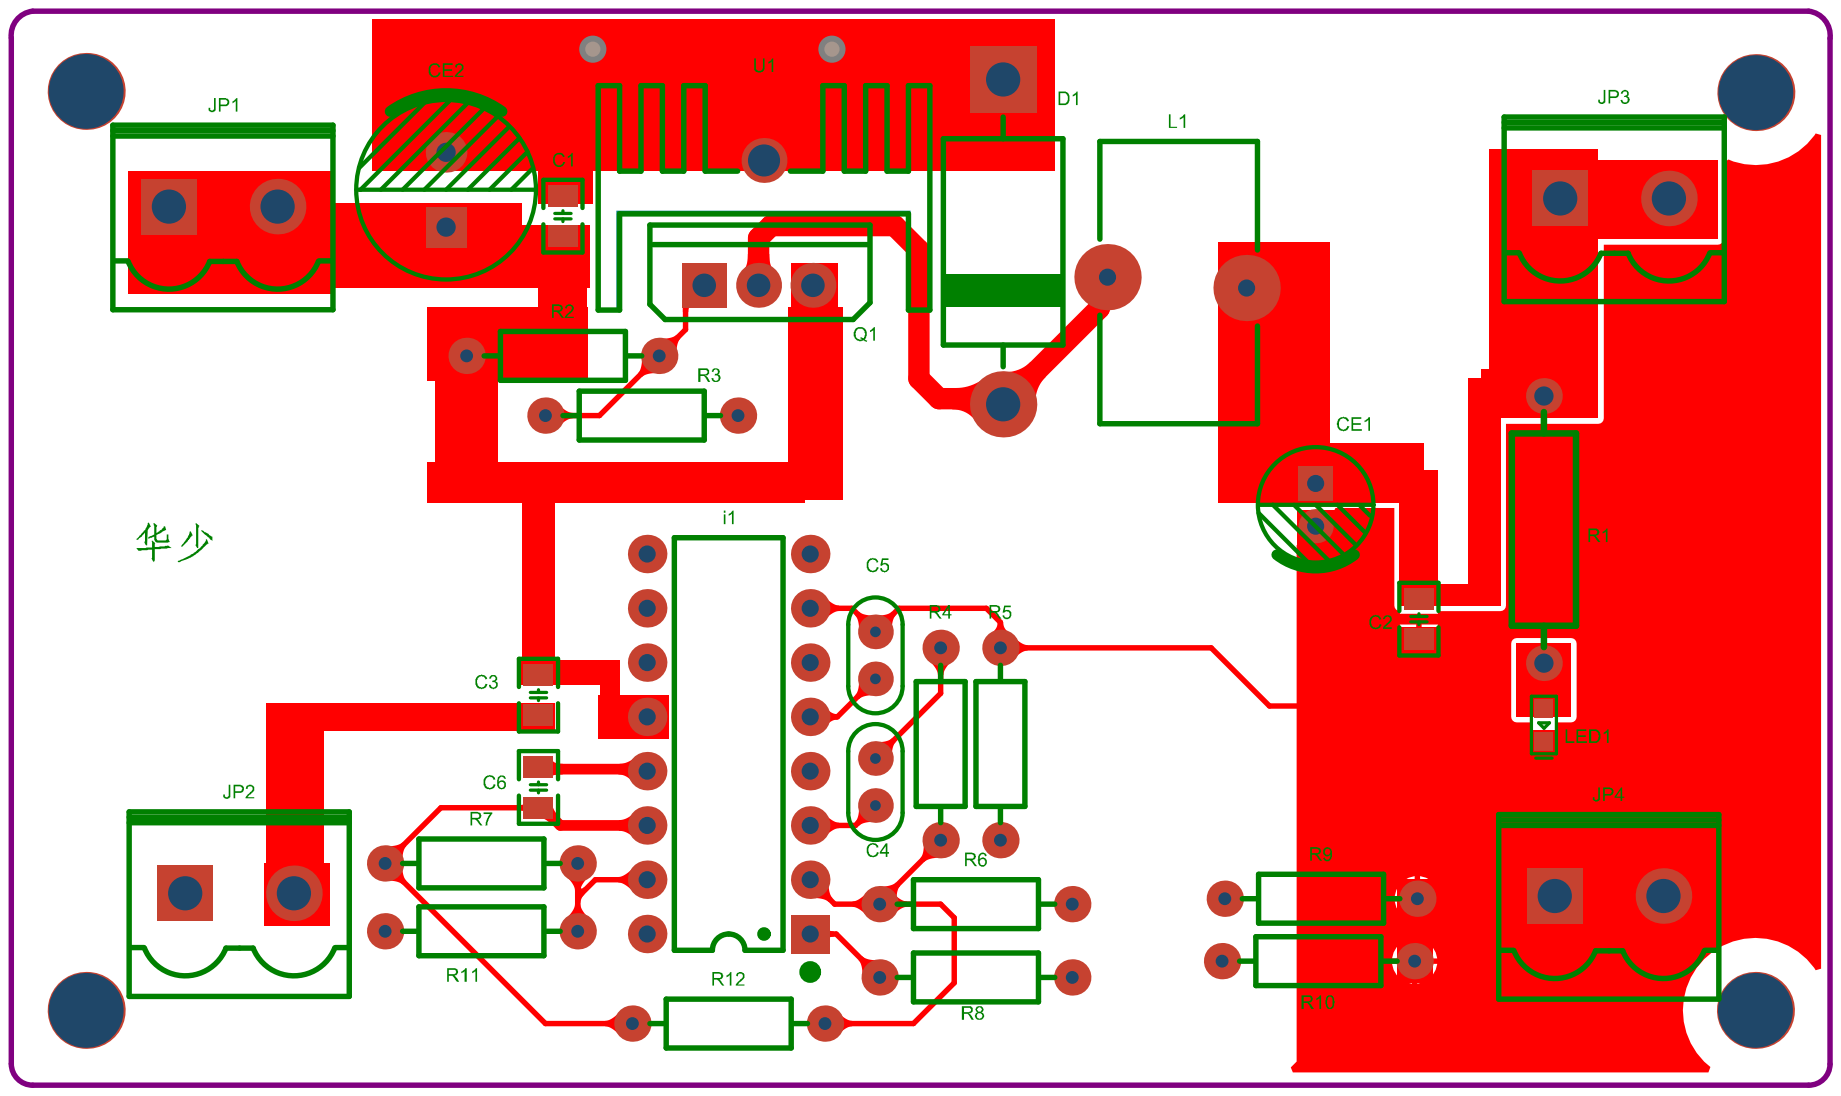
[picture p9: page 1]

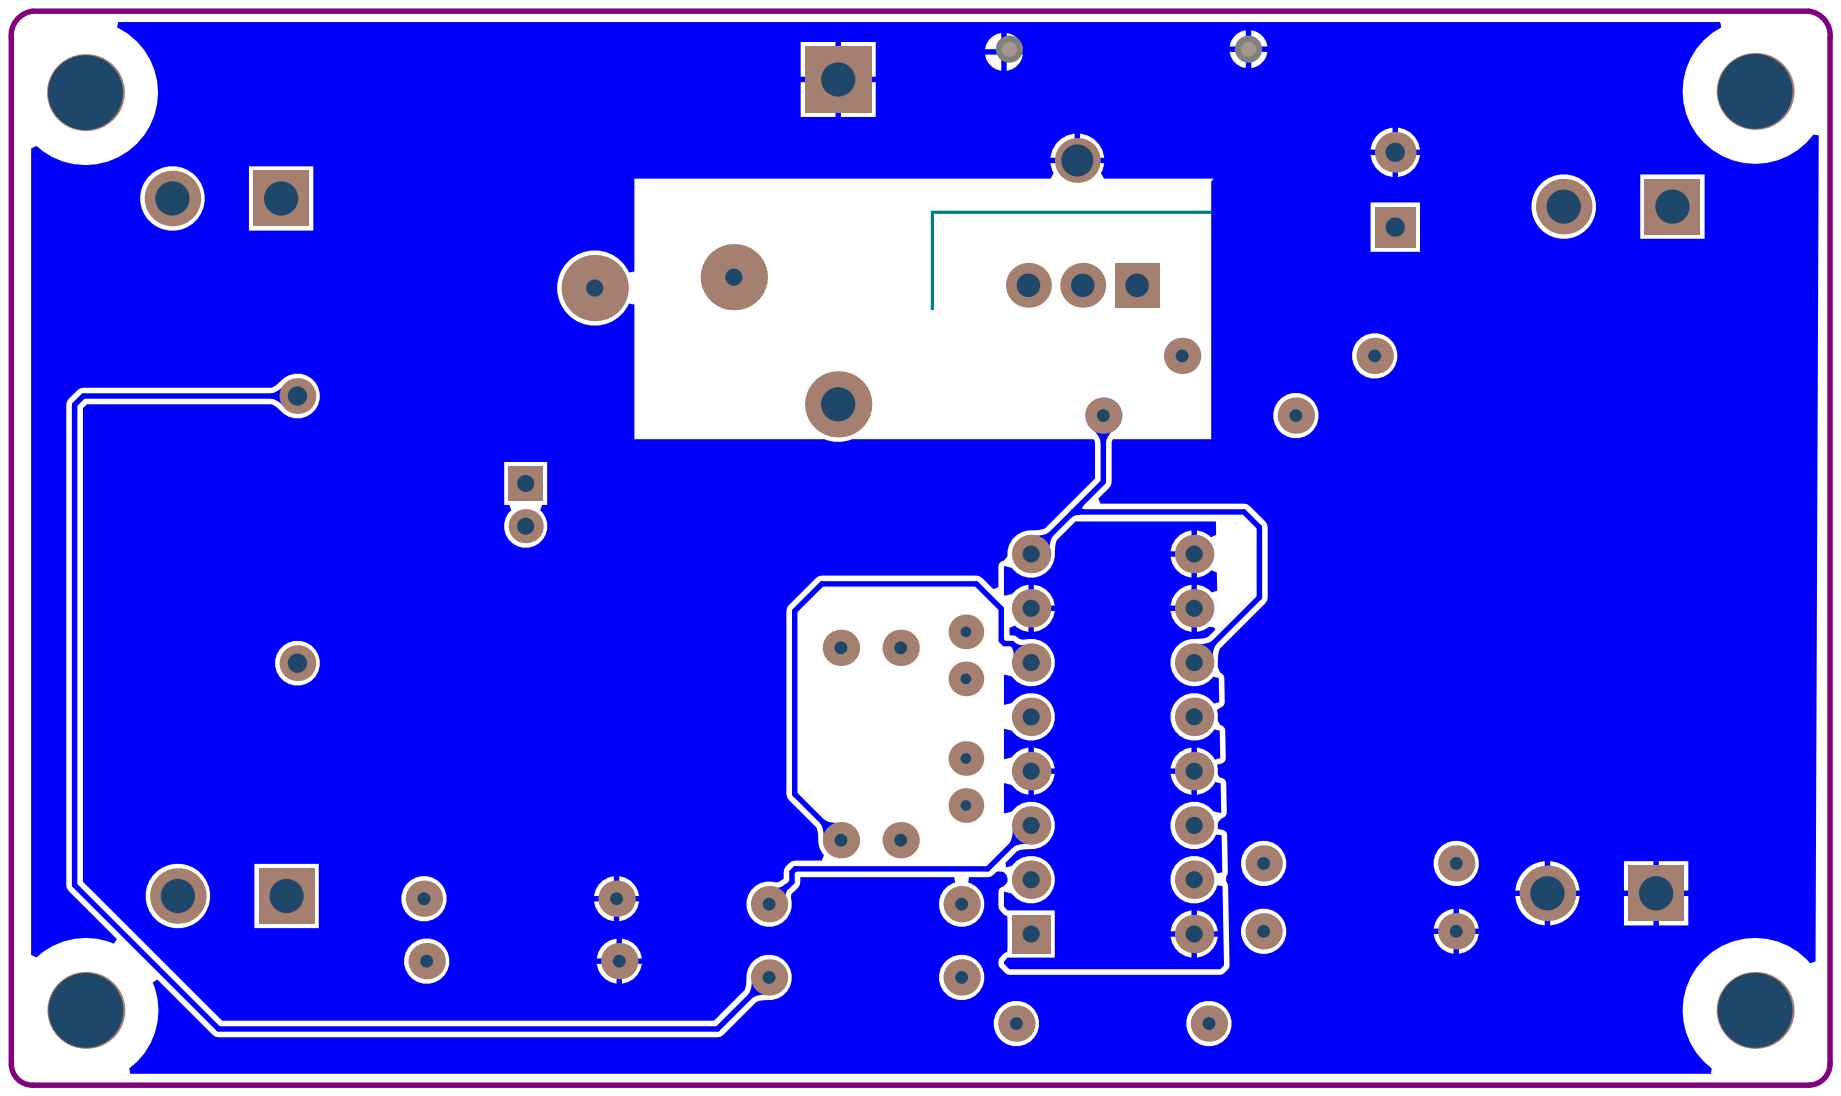
[picture p10: page 2]
