dw-debug/buck-converter/(list of files, drawings)

Other design files:
hardware/buck.PrjPcb
hardware/PCB1.PcbDoc
hardware/Sheet1.SchDoc
PCB1.PcbDoc
Sheet1.SchDoc
