dw-debug/buck-converter/(commit log)

2026-10-28 Initial public release: TL494 buck converter (10-40V in, 5V/1A out)
    Schematic, PCB source (Altium Designer), fabrication outputs and docs
    for a TL494 voltage-mode buck converter with a directly driven
    high-side PNP switch (TIP32A), 0.11 ohm low-side current limit and a
    78 x 43 mm two-layer board.
    [BOM.csv, Fabrication Testpoint Report for PCB1.csv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]
2026-10-28 docs: add PCB layout rules for the TL494 + PNP buck
    Summarise the layout notes as docs/layout-guidelines.md: rule table
    (di/dt vs dV/dt), high-frequency commutation loop, SW node handling,
    floating ground (pin 7 = V-) and V- split, feedback/sampling layout,
    12/14 decoupling, trace-width table, pitfalls, mnemonic and a review
    checklist. The original docx is kept for provenance.
    Also correct the current-limit arithmetic in the notes: with R11 = 150R
    (BOM) the IN2- reference is ~0.143 V / ~1.3 A rather than 2.5 V / 22.7 A,
    and flag it plus the missing decoupling and the 150R LED resistor in the
    README known-issues list.
2026-10-28 恢复到原始目录结构：工程文件与 buck-CAM 回到根目录，README 路径同步更新
    [Fabrication Testpoint Report for PCB1.csv, PCB1.DWG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]
2026-10-28 PCB1.pdf 更新为新的 2 页装配图，移除多余的 hardware/ 目录
2026-10-28 恢复分类结构：工程文件归入 hardware/，生产文件归入 fabrication/，PCB1.pdf 保留新版 2 页导出
    [Fabrication Testpoint Report for PCB1.csv, PCB1.DWG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]
2026-10-28 BOM 源表只保留 hardware/Project Outputs for buck/ 一份
    [buck.xlsx]
2026-10-28 docs: rebuild PCB previews from the Altium composite drawing
    Swap the Gerber-rendered previews for top/bottom views split out of hardware/Composite Drawing.pdf, so the README artwork matches the EDA output: red top copper, blue bottom copper, green silk on bare laminate.
2026-10-28 docs: add a photo of the assembled board
    Also refresh fabrication/assembly/PCB1.pdf with the copper-free assembly printout exported from the current board file.
2026-10-28 docs: crop and orient the board photo
    Trim to the board, rotate to landscape so it matches the PCB previews, and downscale to 1000 px wide.
2026-10-28 docs: 2x2 image grid, drop the photo caption
    Four previews now sit in two rows (schematic + photo, top + bottom); the bare-board photo no longer carries a caption line.
